yasuohayashibara/rdc_arm/README.md

# rdc_arm

Desinged by Autodesk Inventor2024



Main Part List

部品リスト |   |   |   |   |   |  
-- | -- | -- | -- | -- | -- | --
  |   |   |   |   |   | 小計
モータ | SteadyWin | GIM8108-8 |   | 17505 | 3 | 52515
モータ | SteadyWin | GIM3505-8 |   | 18572 | 4 | 74288
アルミフレーム | Misumi | HFS5-2020-300-Z5-XA10-XB40-XC260-XD290 |   | 1150 | 2 | 2300
板金 | Misumi | shoulder_plate | A5052 | 10476 | 1 | 10476
板金 | Misumi | link_plate | A2017 | 5144 | 2 | 10288
板金 | Misumi | elbow_plate | A5052 | 8845 | 1 | 8845
板金 | Misumi | wrist_pitch_plate | A2017 | 7908 | 1 | 7908
板金 | Misumi | wrist_pitch_spacer | A2017 | 4410 | 4 | 17640
板金 | Misumi | wrist_yaw_plate | A5052 | 4514 | 2 | 9028
板金 | Misumi | hand_plate | A5052 | 4914 | 1 | 4914
板金 | Misumi | finger2 | A5052 | 3045 | 1 | 3045
板金 | Misumi | finger1 | POM | 4520 | 2 | 9040
  |   |   |   |   |   |  
  |   |   |   |   |   |  
合計 |   |   |   |   |   | 210287

Weight 2.2kg
