yasuohayashibara/rdc_arm/(list of files, cad)

Other CAD files:
8108-8/8108-8.iam
8108-8/8108-8.ipt
8108-8/V15.ipt
GIM3505-8.ipt
HFS5-2020-300-Z5-XA10-XB40-XC260-XD290.ipt
HFS5-2020-300-Z5-XA10-XB40-XC260-XD290_2.ipt
TF-M5-2.ipt
arm.iam
base_plate.ipt
elbow_plate.ipt
finger_plastic.ipt
finger_plate.ipt
hand_plate.ipt
link_plate.ipt
shoulder_plate.ipt
wrist_pitch_plate.ipt
wrist_pitch_spacer.ipt
wrist_roll_plate.ipt
wrist_yaw_plate.ipt
