yasuohayashibara/rdc_arm/(threads)

Thread 1 (2024-10-26):

過去の設計

yasuohayashibara, 2024-10-26:
設計の履歴を残す

[241013_RDC_ARM.zip](https://github.com/user-attachments/files/17532318/241013_RDC_ARM.zip)

[241013_2_RDC_ARM.zip](https://github.com/user-attachments/files/17532319/241013_2_RDC_ARM.zip)

[241015_RDC_ARM.zip](https://github.com/user-attachments/files/17532320/241015_RDC_ARM.zip)

[241015_2_RDC_ARM.zip](https://github.com/user-attachments/files/17532321/241015_2_RDC_ARM.zip)

yasuohayashibara, 2024-10-26:
issueを閉じます．

Closed 2024-10-26.

Thread 2 (2024-11-03):

溶接部品の発注に関する調査

yasuohayashibara, 2024-11-03:
以下にある部品がmeivy発注で溶接で作られている気がするため調査する．

https://github.com/haraduka/mevius

yasuohayashibara, 2024-11-03:
meivyは溶接も受け付けていることを確認した．
設計の自由度が高まるので助かる．

溶接も自動見積できるようであるが，以下の部品は曲げで引っかかり自動見積はできなかった．

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

yasuohayashibara, 2024-11-03:
それ以上に切削でわりと自由度の高い部品が注文できることに驚いた．
これは切削すると大変そうであるが，それほど高くなくお願いできるようである．

モータ間を繋ぐ部品（これがあると設計が簡単になる）
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

足の部品（これだけ削って2万円強とは．．．）
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

yasuohayashibara, 2024-11-03:
調査が終了したので，issueを閉じます．

yasuohayashibara, 2024-11-03:
わりと微妙な形状もお願いできることを確認

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

Closed 2024-11-03.

Thread 3 (2024-11-17):

基本的な性能

yasuohayashibara, 2024-11-17:
基本的な性能をまとめる

yasuohayashibara, 2024-11-17:
リンク間距離
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

yasuohayashibara, 2024-11-24:
設計を変更（人の腕を参考）

肩から肘までの距離　0.3m
肘から手首までの距離　0.25m

### 基本的なデータ
リンク間距離

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

### 性能
可搬重量（腕を伸ばしたときに支えられる重量）

肩ピッチ軸を基準とする重心までの距離　0.396m
重量　1.220kg
自重を支えるために必要なトルク　4.72Nm

手先で支えられる重量
連続　0.51kg
瞬時　3.21kg

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

yasuohayashibara, 2024-11-24:
### アーム手先の移動の様子

基準の位置 (250, 0)
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

手を伸ばした様子 (450, 0)
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

右遠くに伸ばした様子 (450, 200)
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

左遠くに伸ばした様子 (450, -200)
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

右近くに伸ばした様子 (50, 200)
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

左近くに伸ばした様子 (50, -200)
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

yasuohayashibara, 2024-11-30:
少々設計を変更したところもあるが，基本的な性能をある程度示したのでissueを閉じます．

Closed 2024-11-30.

Thread 4 (2024-11-17):

モータの特性のリストアップ

yasuohayashibara, 2024-11-17:
モータの特性をリストアップする．

### SteadyWin GIM8108-8
https://www.steadywin.cn/en/pd.jsp?id=133#_jcp=3_3

Category | Value
-- | --
Driver   Model | SDC104
Voltage | 24~56V (Nominal 48V)
Power | 336W
Nominal Torque | 7.5Nm
Stall Torque | 22Nm
Nominal Speed | 110rpm
Max Speed | 320rpm
Nominal   Current | 7A
Stall Current | 22A
Gear Rate | 8:1
Motor Weight | 396g
Max Axial Load | 225N
Max Radial   Load | 900N

### SteadyWin GIM3505-8
https://www.steadywin.cn/en/pd.jsp?id=130#_jcp=3_3

Category | Value
-- | --
Driver   Model | SDC101
Voltage | 16~36V (Nominal 24V)
Power | 29W
Nominal Torque | 0.65Nm
Stall Torque | 1.27Nm
Nominal Speed | 225rpm
Max Speed | 384rpm
Nominal   Current | 1.2A
Stall Current | 2.4A
Gear Rate | 8:1
Motor Weight | 97g
Max Axial Load | 75N
Max Radial   Load | 300N

yasuohayashibara, 2024-11-30:
リストアップしたので，issueを閉じます．

Closed 2024-11-30.

Thread 5 (2024-11-25):

安全率の計算

yasuohayashibara, 2024-11-25:
安全率を計算する．

22Nmを加えたときの板金の安全率を計算する．

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

厚さ3mmだと不足する．

yasuohayashibara, 2024-11-25:
安全率を計算する．

厚さを3mm -> 5mmにした．
22Nmを加えたときの板金の安全率を計算する．

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

yasuohayashibara, 2024-11-30:
設計の変更

肩ヨー軸を最大力(22Nm)で駆動したときの安全率を確認

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

板厚を3mm -> 6mmにする．
安全率は改善したが重量が増加する

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

接続する部分の長さを長くする．
重量の増加を抑えて安全率を下げることができる．

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

接合部の安全率の確認

腕を横に伸ばした状態で肩ヨー軸の最大トルク22Nmを出力したときの安全率
回転軸から0.02m程度のところに
22Nm / 0.02m = 1100N (110kg程度)
の並進力が加わるとして計算

板厚3mm(重量21g)の場合
安全率が低い．
大きな外力が加わったときに曲がる可能性がある．
（曲がったほうが環境に与えるダメージを減らすという観点から望ましいかもしれないが）

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

板厚5mm(重量35g)の場合

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

yasuohayashibara, 2024-11-30:
安全率を計算して，重要なパーツに関して最低限の強度になったと思われるのでissueを閉じます．

Closed 2024-11-30.
