yasuohayashibara/rdc_arm/(commit log)

2024-10-27 add parts_list.xlsx
    [parts_list.xlsx]
2024-11-24 short arm
    [8108-8.ipt, GIM3505-8.ipt, HFS5-2020-300-Z5-XA10-XB40-XC260-XD290.ipt, HFS5-2020-300-Z5-XA10-XB40-XC260-XD290_2.ipt, arm.iam, elbow_plate.ipt]
